Iherrbenza/AD9959_Python/DDS_ESP32_PCB/ESP32_AD9959_board.jpg

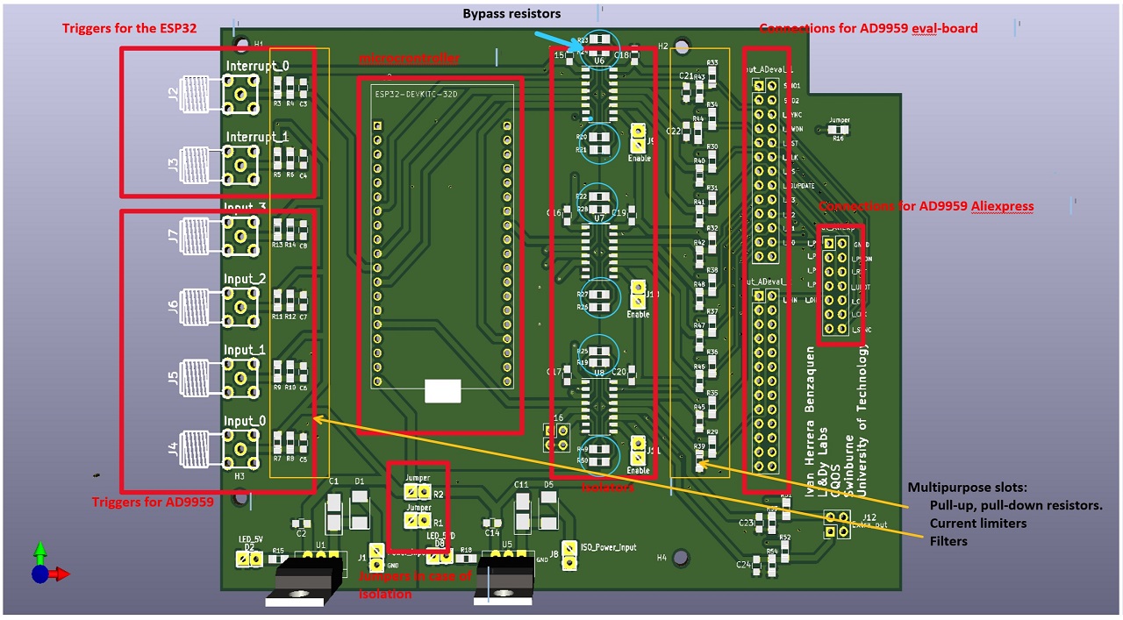
DDS_ESP32_PCB/ESP32_AD9959_board.jpg
