Iherrbenza/AD9959_Python/DDS_ESP32_PCB/ESP32_AD9959_schematics.pdf

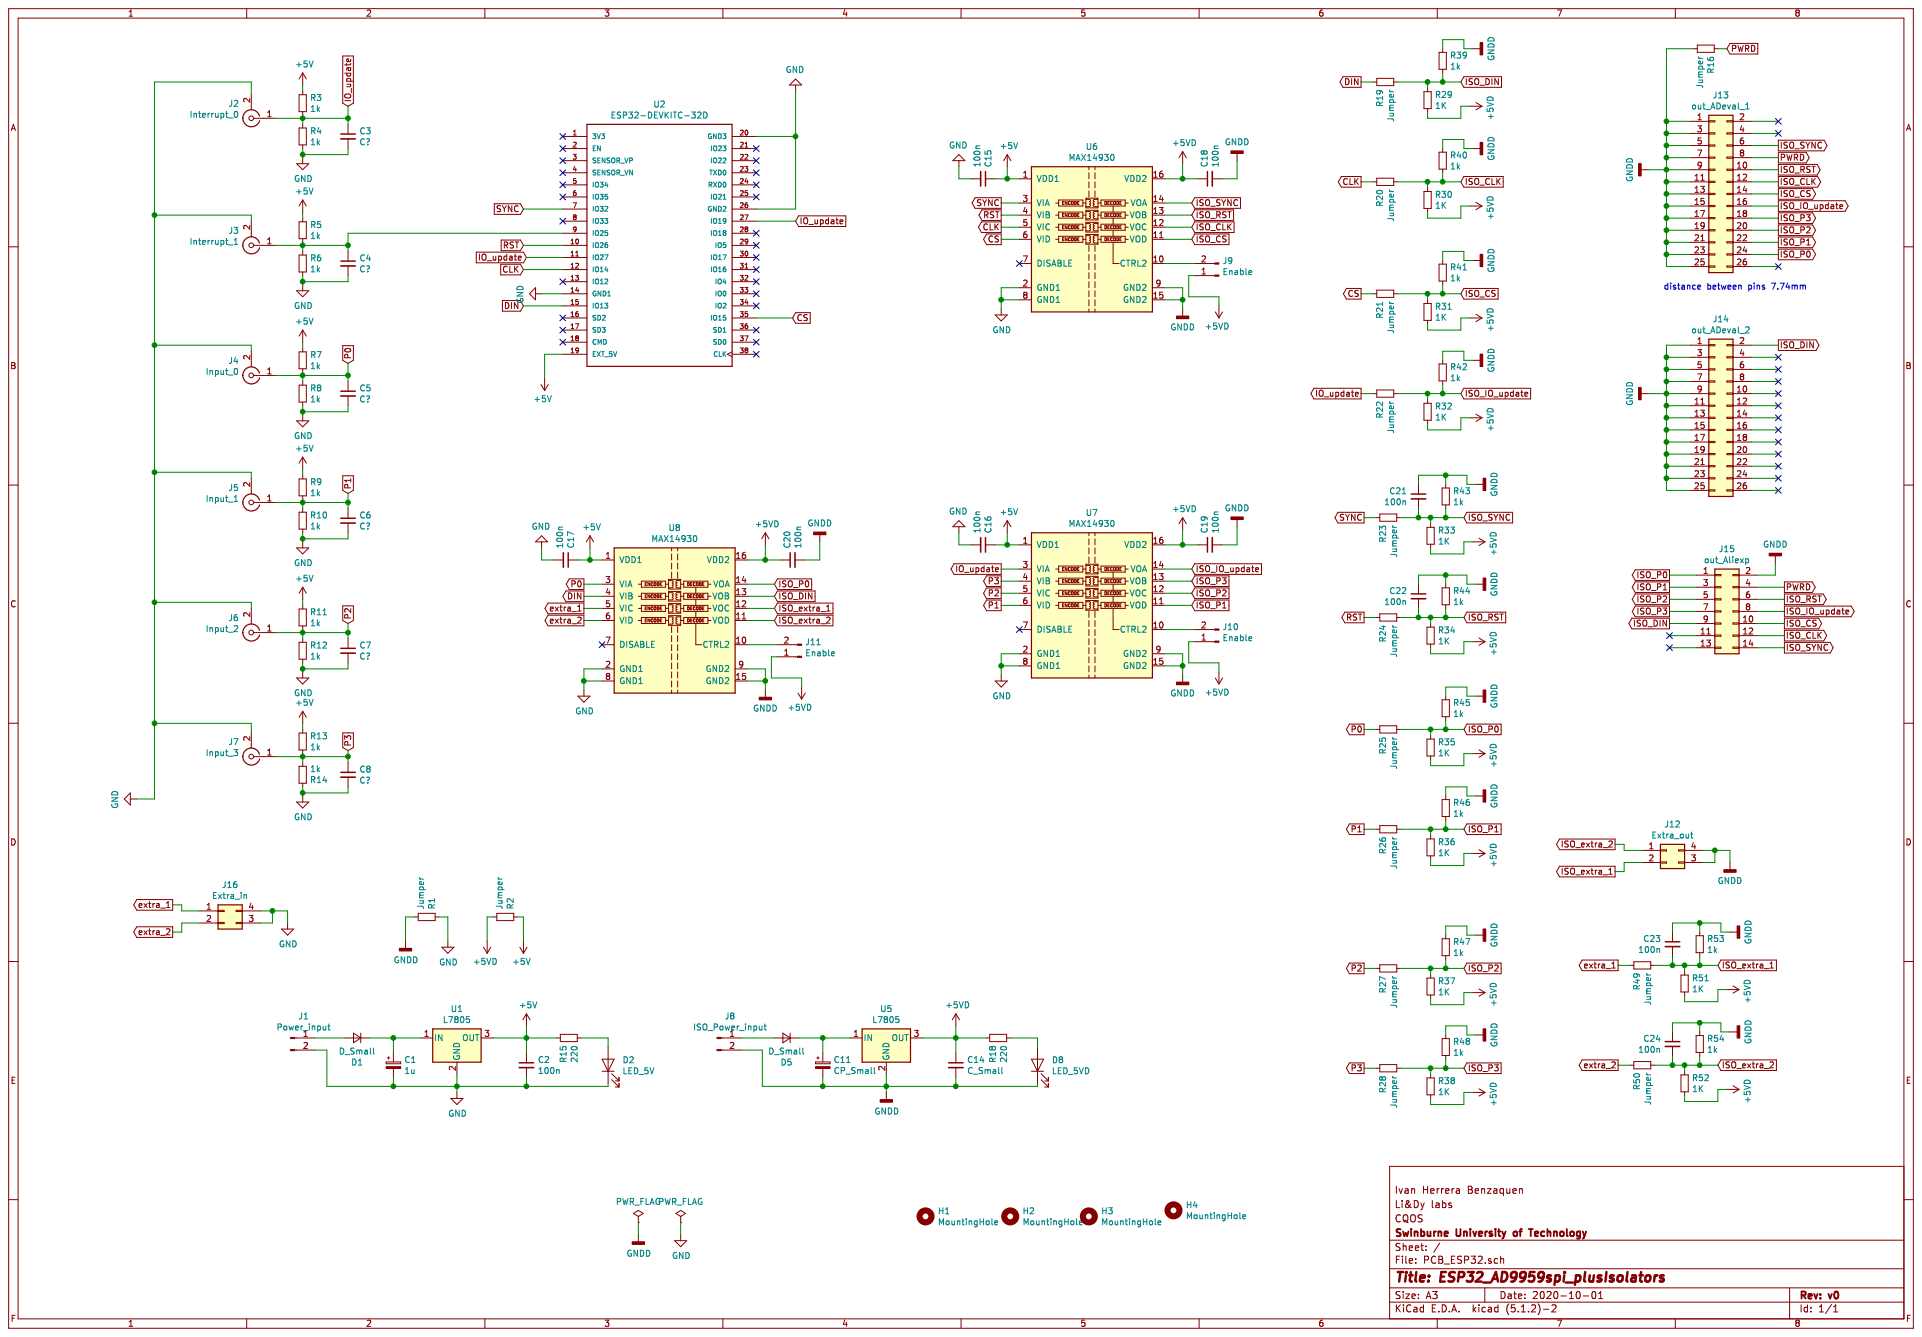
[picture p2: page 1]
