Iherrbenza/AD9959_Python/DDS_ESP32_test/Labscript_2levelamplitude_mod.png

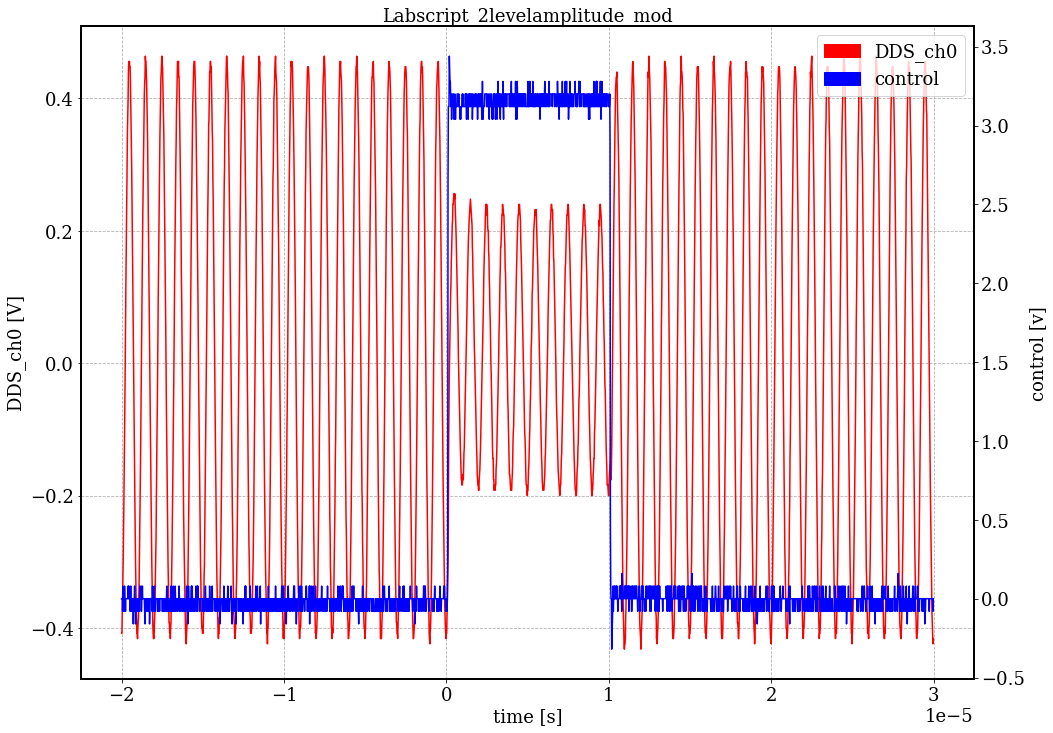
DDS_ESP32_test/Labscript_2levelamplitude_mod.png
