Iherrbenza/AD9959_Python/DDS_ESP32_test/Labscript_2levelphase_mod.png

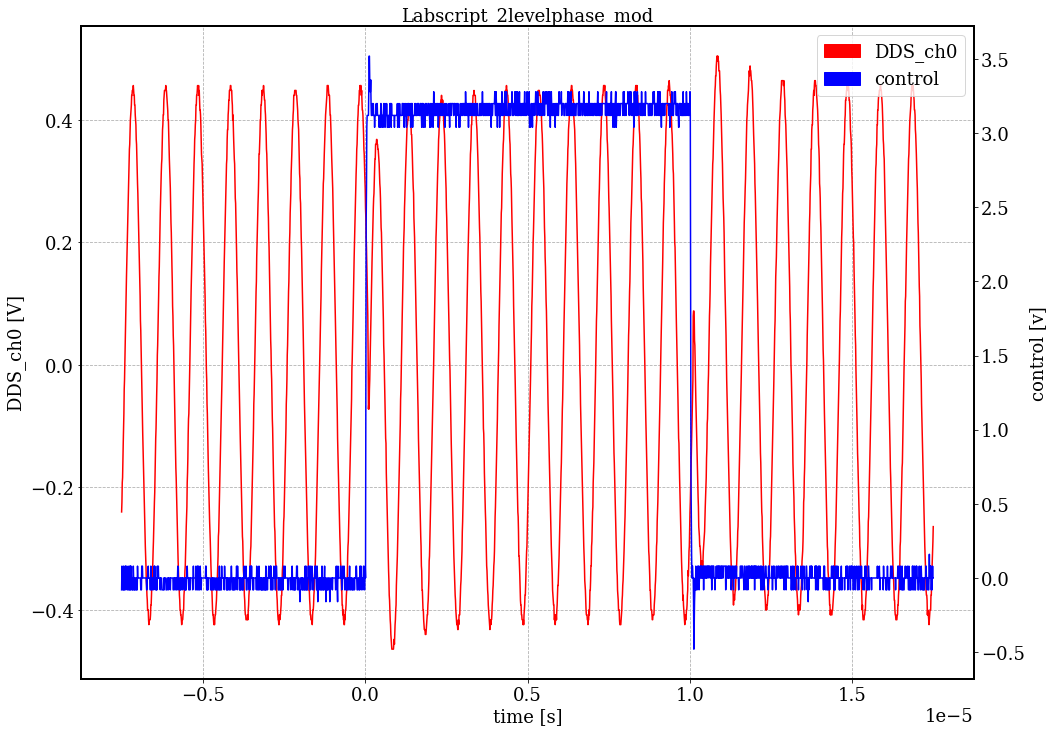
DDS_ESP32_test/Labscript_2levelphase_mod.png
