Iherrbenza/AD9959_Python/DDS_ESP32_test/Linear_sweep_amplitude_down.png

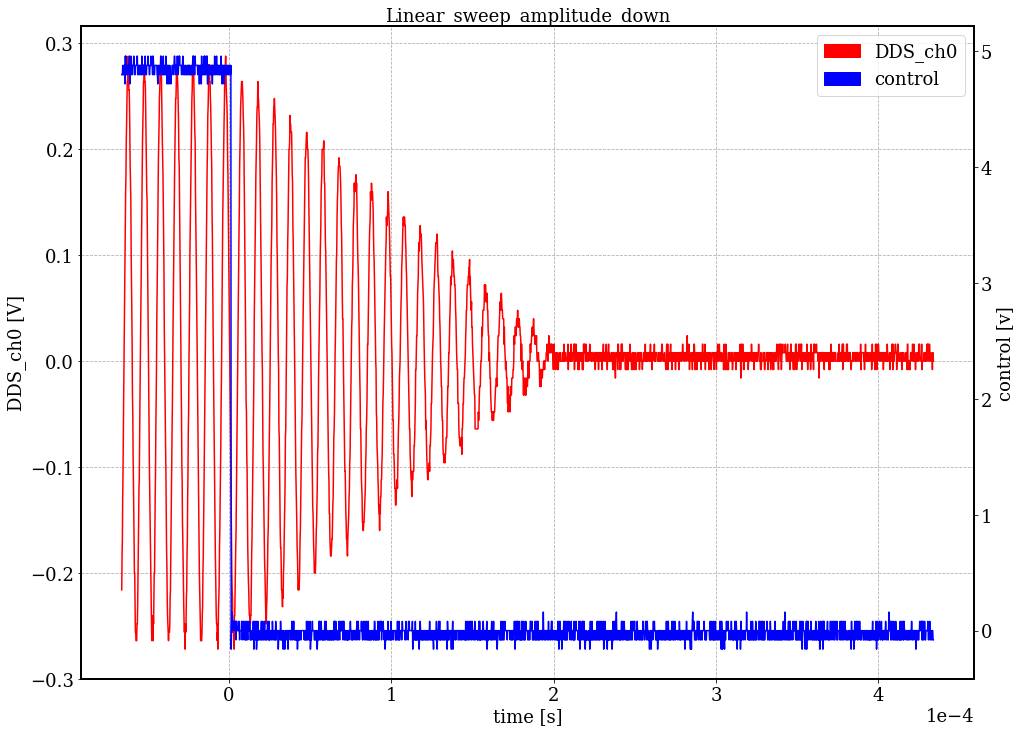
DDS_ESP32_test/Linear_sweep_amplitude_down.png
