Iherrbenza/AD9959_Python/DDS_ESP32_test/Linear_sweep_frequency_up.png

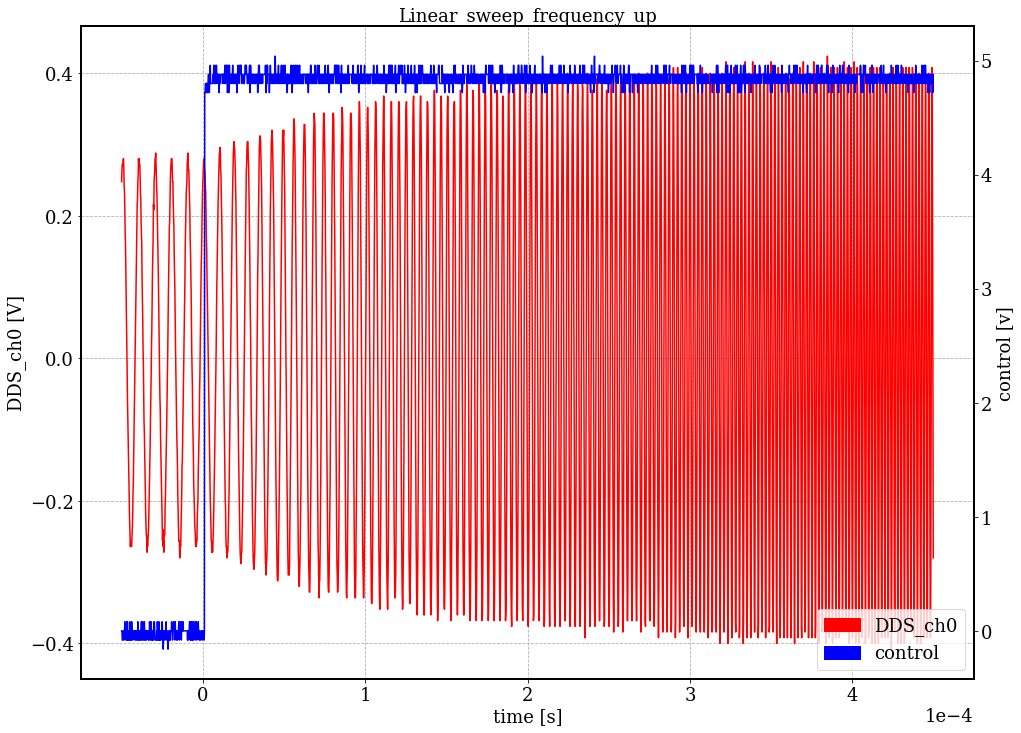
DDS_ESP32_test/Linear_sweep_frequency_up.png
