Iherrbenza/AD9959_Python/DDS_ESP32_test/Two_level modulation_phase_down.png

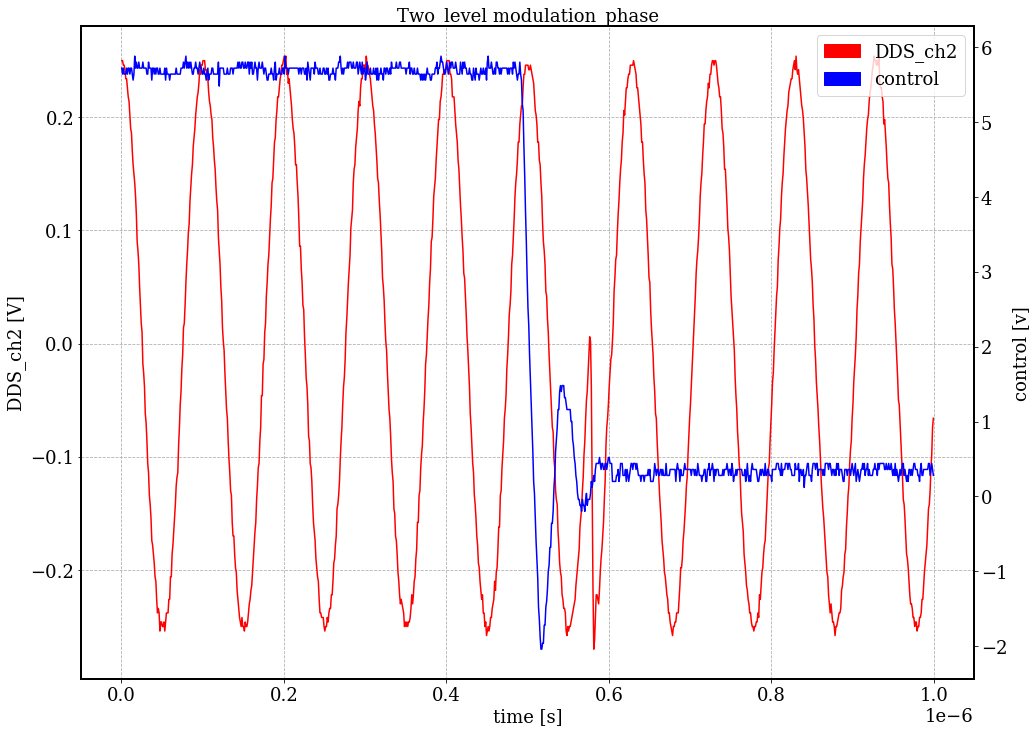
DDS_ESP32_test/Two_level modulation_phase_down.png
