Iherrbenza/AD9959_Python/(commit log)

2021-07-16 Arduino files
2021-07-16 info headers fro the arduino files
2021-07-20 adding last files
    [ESP32_AD9959_BOOM.csv]
2021-07-20 changed dimensiong #D board image
